JKamue/Rocketry/README.md

# Rocket projects

This serves as a common repository where I will document all my rocket builds and share as well as analyze the data generated from launching them.

<p align="center">
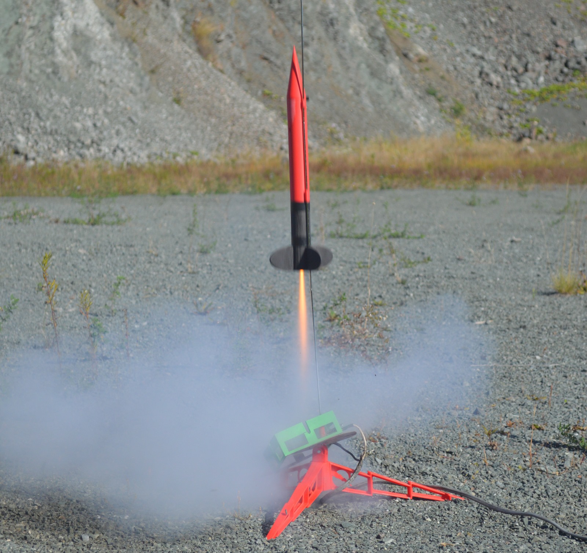
[picture p1: Pathfinder/DataAnalysis/title-picture.jpeg]
  
</p>

## Rockets

### Pathfinder

#### Goals
The goal of pathfinder was to test the viability of 3D printed rocket parts and cheap Sensors / Microcontrollers for use in a DIY rocket.

#### Launches

| Date | Outcome | Comment | Docs |
|--|--|--|--|
| 2024-09-29 17:39 | Partial failure | Destruction on impact when parachutes failed but full launch data was recorded and recovered | [Report](https://github.com/JKamue/Rocketry/releases/download/pathfinder/pathfinder.pdf) |
