JKamue/Rocketry/Pathfinder/DataAnalysis/analysis.pdf

# Exploring Low-Cost DIY Rockets with Flight Recording using 3D Printing and Low-Cost Sensors

### Design, Launch, Data Analysis, and Lessons Learned

### Jannes Kaspar-Müller

2024-11-03


## Contents

1 Goals | 4
2 Design | 5
3 Launch | 8
4 Conclusion | 29
5 Appendix | 30
References | 45

## List of Figures

1 | Rocket components and assembly | | 6
2 | Simulated rocket | | 7
3 | Altitude as measured by the barometric pressure sensor | | 8
4 | Vertical Speed as measured by the barometric pressure sensor | | 9
5 | Vertical Acceleration as measured by the barometric pressure sensor | 10
6 | Raw Acceleration as measured by the Accelerometer | 11
7 | Total Acceleration as measured by the Accelerometer | 12
8 | Rocket roll rotations during flight | 13
9 | Measured roll compared to maximum range | 14
10 | Amount of rotations around roll axis | 15
11 | GPS horizontal dilution of precision | 16
12 | Total speed measured by GPS | 17
13 | Altitude measured by GPS | 18
14 | 2D position of rocket based on GPS | 19
15 | Horizontal distance of rocket based on GPS | 20
16 | Horizontal speed of rocket based on GPS | 21
17 | Comparison of GPS and barometer altitude measurements | 22
18 | 3D position of rocket based on GPS and Barometer data | 22
19 | Total distance covered by rocket based on GPS and Barometer | 23
20 | Total speed of rocket based on GPS and Barometer | 24
21 | Total speed of rocket compared to vertical speed | 24
22 | Correlation between speed and roll | 25
23 | Rocket rotation during flight | 26
24 | Simulated altitude compared with measured altitude | 27
25 | Simulated vertical acceleration compared with measured acceleration | 28

## 1 Goals

1. The rocket should be easy and cheap to build. It should be possible to build multiple rockets of the same type and losing some of them should not hurt financially.
2. The rocket should be able to handle a variety of different motor sizes. Ideally a launch campaign would start at small altitudes and work its way up.
3. During the flight the rocket should be capable of recording as much flight data as possible and store it to be analyzed later.

## 2 Design

The design section is divided into three parts. The first covers the rocket’s overall design, detailing its structure and components. The second explains the simulations conducted to evaluate the rocket’s expected performance and stability. The final part outlines the features of the flight recorder and the key decisions made during its development.

### 2.1 Rocket Structure

The rocket follows a traditional hobbyist design, featuring a single motor located at the base with no active guidance system (Center, 2024). To ensure stability during flight, fins are positioned at the bottom. Additionally, since the rocket is intended for recovery, the nosecone must be detachable, triggered by the ejection charge from the motor. This requires the ejection blast to travel the full length of the rocket to the nosecone without damaging the on-board electronics responsible for recording flight data. Based on these goals, the following decisions were made regarding the design and manufacturing of the rocket:

### 2.1.1 The Case for 3D Printing

Due to the goals of affordability and easy of manufacturing the decision to use 3D printing to manufacture as many pieces of the rockets as possible was made. 3D printing allows anybody with access to the 3D model of the rocket to produce it nearly identical. The widespread adoption of 3D printing for hobby projects made printers as well as filament widely available, cheap to obtain and easy use. Therefore the rocket can not only be replicated with low complexity for the builder but also at a minimal cost or effort involved (Pearce & Qian, 2022). Additionally the process of 3D printing allows to easily build geometries that would usually be hard or expensive to machine or produce at small production volumes and scales (Berman, 2012, 2020). Specifically FDM 3D printing was used to build the complete Rocket structure.

Different 3D printing filaments offer different strength or density properties that might be more beneficial to use on different parts of the rocket (Bambu Lab, 2024). The most used hobbyist Filament, PLA, is an all rounder, offering good toughness, strength, stiffness, layer adhesion and ease of printing for a low price per kilogram. For this reason, PLA was chosen as the default material for most parts of the rocket that aren’t subjected to high forces or extreme temperatures.

The option of printing certain components in more expensive, ultra-lightweight filaments like ASA Aero (ASA infused with a temperature-activated foaming agent) was considered. However, this approach was ultimately set aside due to the reduced strength and increased printing complexity, which limits the ability to create intricate designs to some extent.

### 2.1.2 Selected Materials

There are 2 parts on the rocket that required further consideration before selecting the filament:

1. The fins of a rocket are often quite thin and stick out of the rocket body often making contact first when impacting during soft landings or transportation. Therefore requiring a higher impact resistance.
2. The parts coming into contact with the rocket motor will heat up more and should be made out of a material capable of handling higher temperatures than PLA.

Therefore these 2 parts were printed together in PA6-CF which features both a high impact and temperature resistance. The other parts of the rocket were all printed in cheap, easy to use PLA.


Figure 1: Rocket components and assembly

### 2.1.3 Parts

The rocket consists of 6 components.
The fins and motor assembly is split in two halves and screws into the white flight computer assembly. This allows mounting motors of different sizes by using various sized adapter before closing the motor assembly and screwing it in.
The red tube is just a cover with holders for the launch rods as well as openings for LEDs and sensors. The detachable nosecone is placed on top of the tube. A small thin disk is placed on top of the flight recorder to create a small parachute compartment. On top of the parachute compartment a nose cone is placed loosely. The flight computer assembly is built around a hollow tube that starts at the motor assembly. This directs the blast upwards to the parachute compartment. The blast will push the parachute against the nose cone, separating it from the rocket and opening up the parachute.

### 2.2 Performance & Stability Simulations

The whole rocket with all parts and weights was replicated in OpenRocket to predict the stability and flight characteristics. Later on the actual data will be compared with the simulated data.

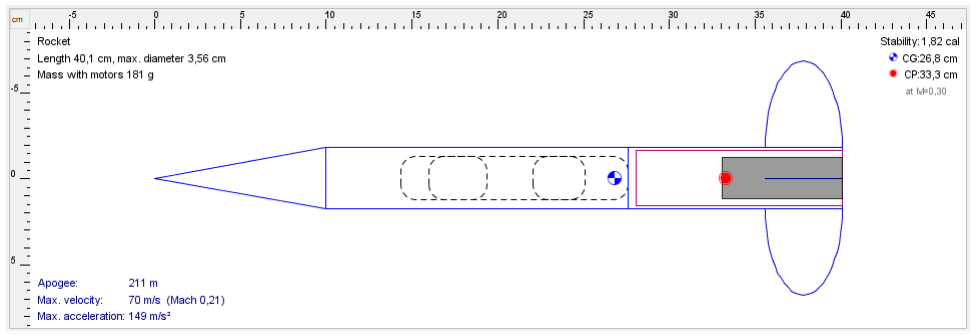
[picture p4: figure]

Figure 2: Simulated rocket

### 2.3 Flight Recording System

The goal of the flight recording system was to cheaply record as much data as possible. The heart of the system was a Lolin32. The WiFi capability allowed connecting to the flight recording system on the launch pad to ensure that all sensors were working. Additionally it supports charging and using a small 3.7v LiPo battery which was used to power the rocket during flight.
To store the recorded data a cheap SPI micro SD module was used.
3 types of sensors were added to the flight recording system. All of them are widely available and cheap making them ideal to build multiple flight recorders in the future without being afraid of losing some.
1. For measuring barometric pressure the BMP388 was chosen. This sensor should be able to provide the most accurate altitude data.
2. To measure the rockets acceleration and orientation the MPU6050 was chosen as an IMU.
3. In order to get the precise location of the rocket above the ground the BE-220 was used as a GPS. The GPS was also re-programmed to allow for a higher data rate.

## 3 Launch

In this chapter I will first analyse the launch based on the data the various sensors recorded. Following that I will compare the actual measurements with the result of the simulation. This chapter concludes with a failure analysis that summarizes all encountered issues and investigates their root causes, aiming to prevent similar and related failures in the future.

The launch was conducted with a D12-5 motor.

### 3.1 Data Analysis

The data analysis will first take a look at each sensors individual measurement. At the end the data of multiple sensors will be combined to get a more comprehensive understanding of the flight and to compare performance as well as accuracy of sensors.

### 3.1.1 Pressure Sensor

The primary function of the barometric pressure sensor is to measure the rocket’s altitude throughout its flight. With an accuracy of approximately ±8 Pa, it can determine altitude to within ±0.5 m (Gravity, 2020). Since each point in the following figure represents the difference between the initial ground measurement and the reading at that specific moment, the cumulative accuracy adjusts to about ±1m — still providing a very reliable measurement. Additionally locally weighted scatterplot smoothing (LOWESS) has been used to plot an additional curve that is less susceptible to the minor variations in the sensors measurements.

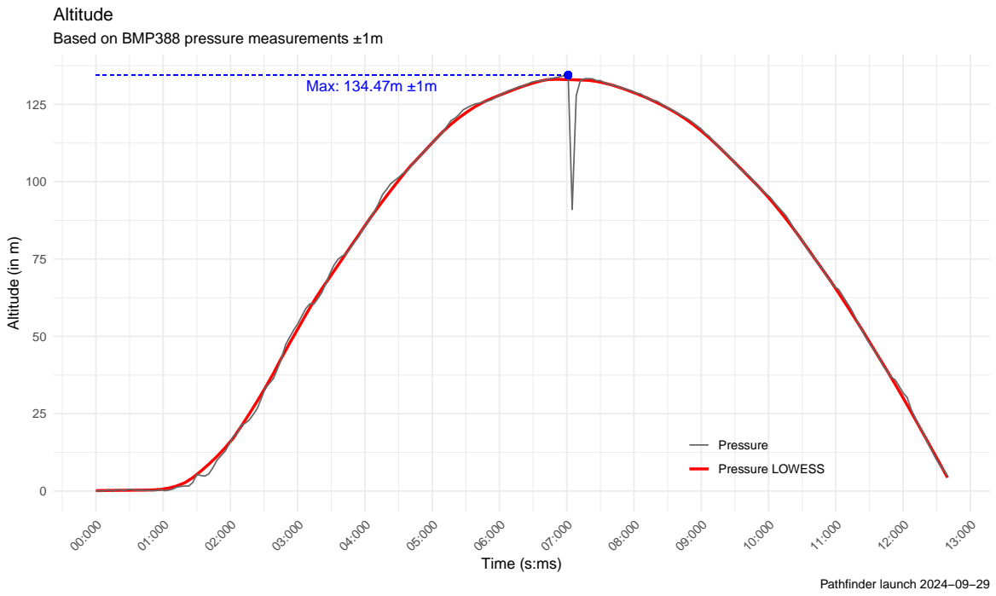
[picture p5: figure]
Max: 134.47m ±1m; Time (s:ms); Altitude (in m); Pressure; Pressure LOWESS; Altitude; Pathfinder launch 2024−09−29

Based on BMP388 pressure measurements ±1m

Figure 3: Altitude as measured by the barometric pressure sensor

The data shows a steep ascent between 1:00 and 2:00 followed by a slow increase until the peak of 134.47m is reached at 7:00. At this point all upwards velocity is lost due to gravity and friction. Gravity now continues to accelerate the rocket towards the ground again. Since the rocket moves faster and faster towards the ground it becomes apparent that the parachute system failed. The ejection charge was supposed to release the parachute at roughly 8:00 but the nose did not manage to seperate causing the rocket to impact the ground without slowing down.

The sudden drop shortly after the peak is reached (or perhaps covering the timeframe where the peak was really reached) is quite interesting to see. It’s difficult to determine whether this dip is due to measurement error occurring coincidentally at this time, or if the rocket encountered a unique pressure phenomenon at its peak Additional flights might bring more insight if this is merely a correlation or if this is actually caused be the rocket reaching its peak. Perhaps future flights might also profit from redundant sensors.

Using the altitude data, the gradient of altitude can be calculated to determine the rocket’s vertical speed. While the barometric pressure recorded by the sensor might look smooth at a first glance it becomes apparent that the minimal variations in the sensors measurements result in huge spikes when calculating the gradient. Calculating the gradient of the altitiude LOWESS yields a lot better and cleaner results that should still be very accurate since it only reduces the variation and doesnt alter the curves trajectory. This graph shows that the maximum vertical speed was around 40 m/s.

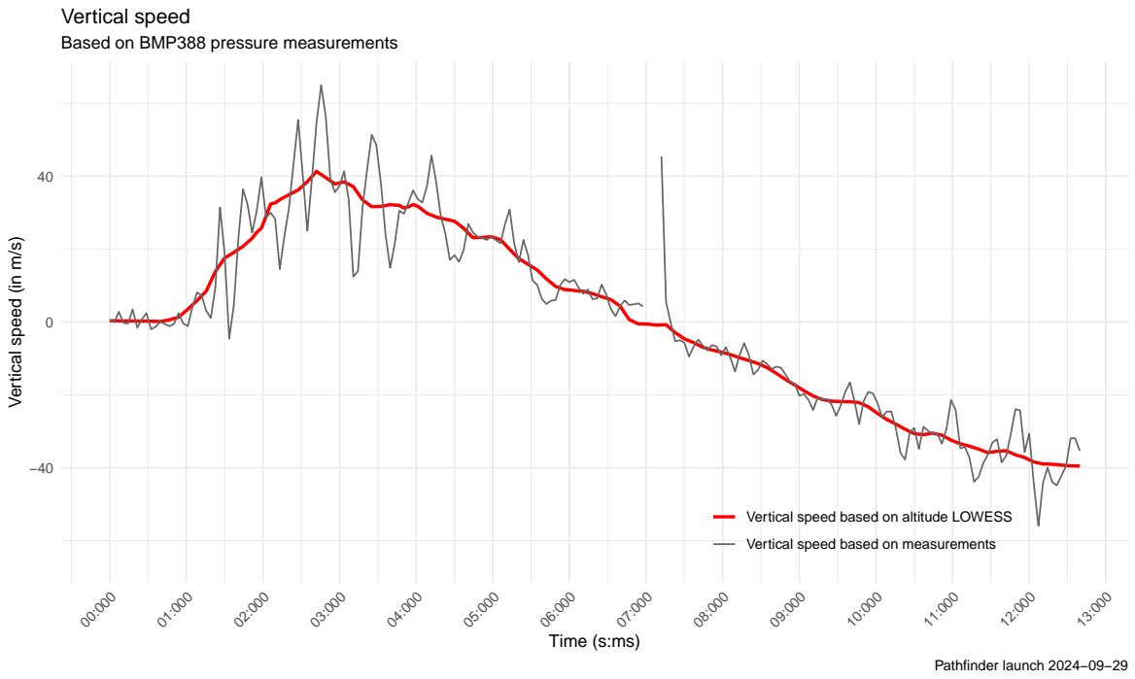
[picture p6: figure]
Time (s:ms); Vertical speed (in m/s); Vertical speed based on altitude LOWESS; Vertical speed based on measurements; Based on BMP388 pressure measurements; Vertical speed; Pathfinder launch 2024−09−29

Figure 4: Vertical Speed as measured by the barometric pressure sensor

Trying to calculate a gradient from either of the calculated vertical speeds yielded no usable results. In this case even the variations of the LOWESS are to significant to produce usable data. Perhaps calculating another LOWESS based on the Vertical speed LOWESS might produce nicer looking results but it is questionable how accurate those would still be.

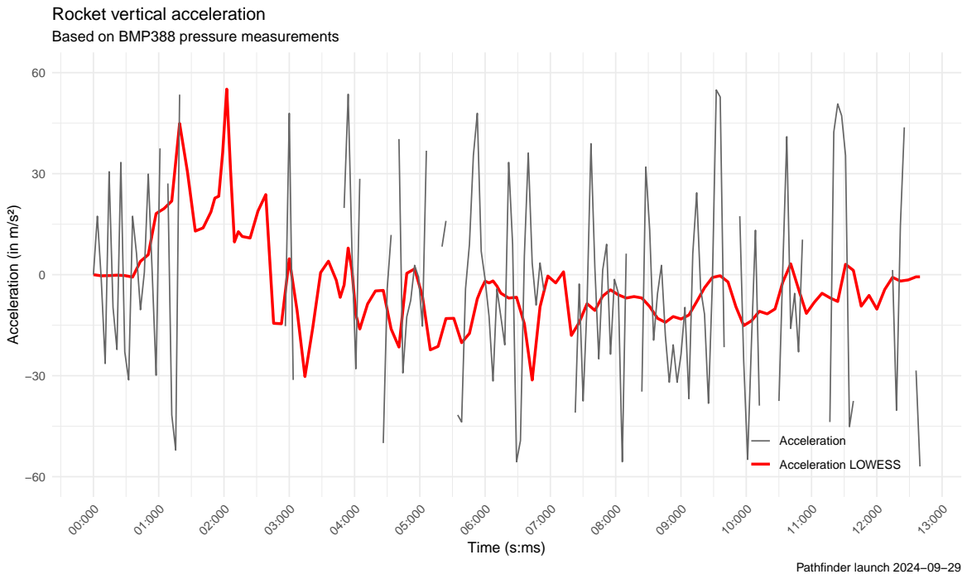
[picture p7: figure]
Time (s:ms); Acceleration (in m/s²); Acceleration; Acceleration LOWESS; Based on BMP388 pressure measurements; Rocket vertical acceleration; Pathfinder launch 2024−09−29

Figure 5: Vertical Acceleration as measured by the barometric pressure sensor

The barometric pressure sensor is the perfect sensor for determining the altitude during the flight accurately. The high velocity of the rocket does not seem to have decreased the quality of measurements except perhaps the sudden decrease and increase shortly after or during the peak of the rocket. Variations in the individual measurements make it hard to calculate a gradient but using local regression it is possible to still determine the speed of the rocket during the launch. The variations seem to be to high to calculate the acceleration of the rocket though which is a bummer since it would have been interesting to compare the vertical acceleration measured by the pressure sensor and the accelerometer.

### 3.1.2 Accelerometer

The accelerometer recorded the acceleration of the rocket in 3 axis during the launch. The most interesting axis is the vertical axis labeled with Y in the graphic below. As expected the vertical acceleration matches the thrust curve of a D12-5 engine in shape and duration (Estes, 2023) confirming the validity of measurements to some degree.

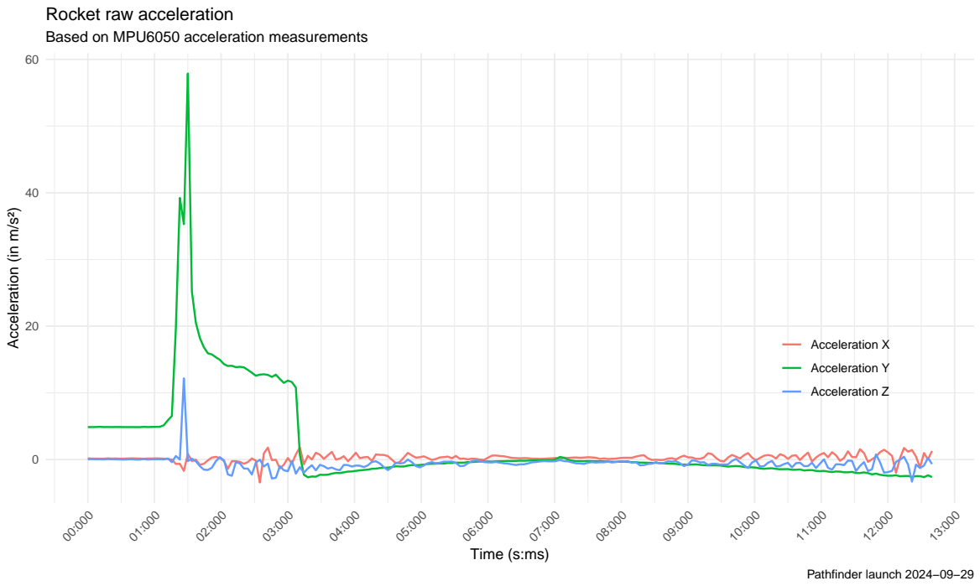
[picture p8: figure]
Time (s:ms); Acceleration (in m/s²); Acceleration X; Acceleration Y; Acceleration Z; Based on MPU6050 acceleration measurements; Rocket raw acceleration; Pathfinder launch 2024−09−29

Figure 6: Raw Acceleration as measured by the Accelerometer

While the general shape of the thrust might look okay and follow expectations a closer inspection shows that the accelerometer data is actually flawed. During the period on the ground before lift-off there should have been a force of roughly 9.81 m/s² representing gravity. Instead the total acceleration on all axis before liftoff was only 4.87-4.91m/s². This seems to be pretty exactly half of the expected acceleration hinting at a scaling issue in either the library or the accelerometers scale factor that is calibrated at the factory. Simply multiplying measured values by two yielded unsatisfactory results and it is very likely that poor understanding and integration of this sensor ahead of flight made the data unusable.

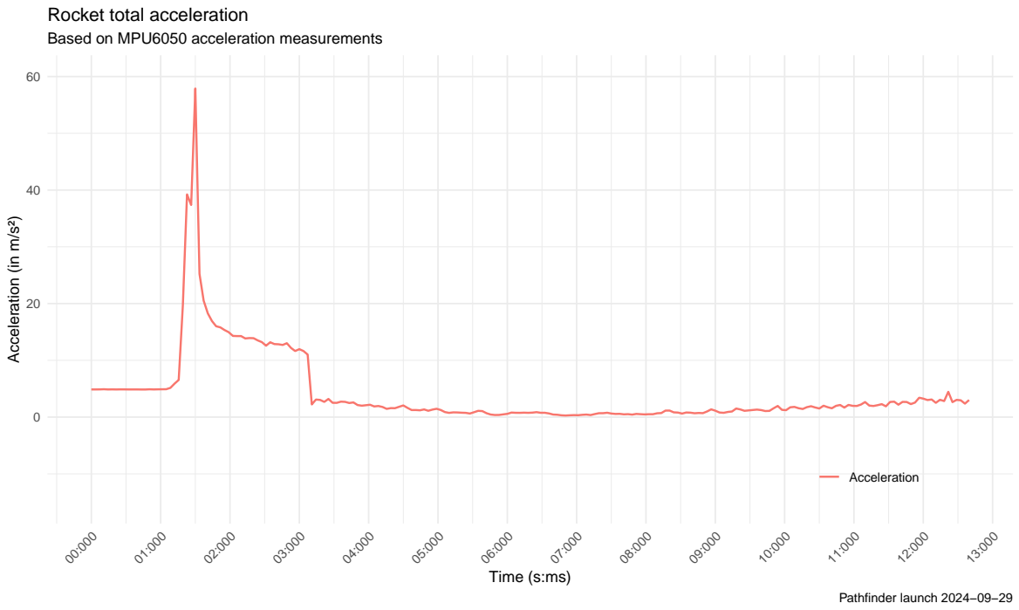
[picture p9: figure]
Time (s:ms); Acceleration (in m/s²); Acceleration; Based on MPU6050 acceleration measurements; Rocket total acceleration; Pathfinder launch 2024−09−29

Figure 7: Total Acceleration as measured by the Accelerometer

Further flights must take a closer look at the accelerometer before launching, particularly ensuring that the expected acceleration of gravity is present before launch for the collected data to be trustworthy. Also settings like the accelerometer range and filter bandwidth as well as other settings must be better understood before taking flight. It might also make sense to compare multiple different libraries or reading the sensor directly to get all the raw data that can be processed after and not during the flight.

### 3.1.3 Gyroscope

The angular speed measured by the gyroscope during the flight can be seen below. It is immediatelly obvious that the rocket experienced the highest angular speed around its roll axis during the flight.

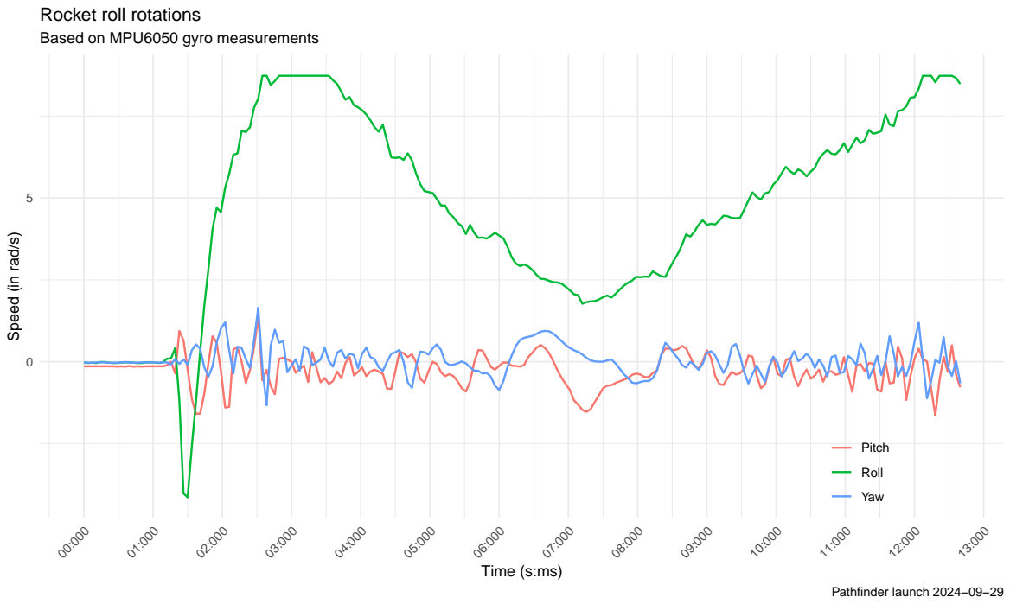
[picture p10: figure]
Time (s:ms); Speed (in rad/s); Pitch; Roll; Yaw; Based on MPU6050 gyro measurements; Rocket roll rotations; Pathfinder launch 2024−09−29

Figure 8: Rocket roll rotations during flight

As seen here the roll speed of the rocket was even greater than the limit of 500 deg/s. This limit was arbitrarily chosen before the flight and options for 1000 deg/s as well as 2000 deg/s were also available. The chart highlights that this limit was crossed in two intervals during the flight leading to the loss of data that could have been prevented with a better understanding of data ranges before the flight. It also is visible, that the highest roll speed was achieved during ascent an descent of the rocket.

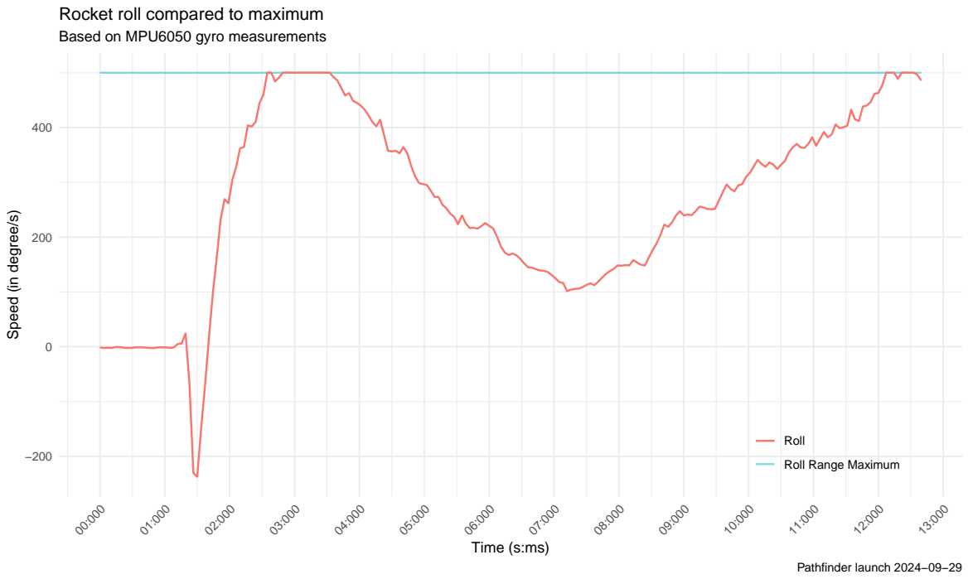
[picture p11: figure]
Time (s:ms); Speed (in degree/s); Roll; Roll Range Maximum; Based on MPU6050 gyro measurements; Rocket roll compared to maximum; Pathfinder launch 2024−09−29

Figure 9: Measured roll compared to maximum range

Overall the roll axis speed was quite high. Calculating the total amount of rotations by integrating the speed shows that the rocket did at least 9.39 rotations in a timeframe of 11.1 seconds averaging 0.85 rotations per second. Since roll data was lost the actual amount of rotations is assumed to be even higher. This is significant because future rockets might have a camera attached to them. A high roll rate will make the recorded footage during ascent and decent unusable.

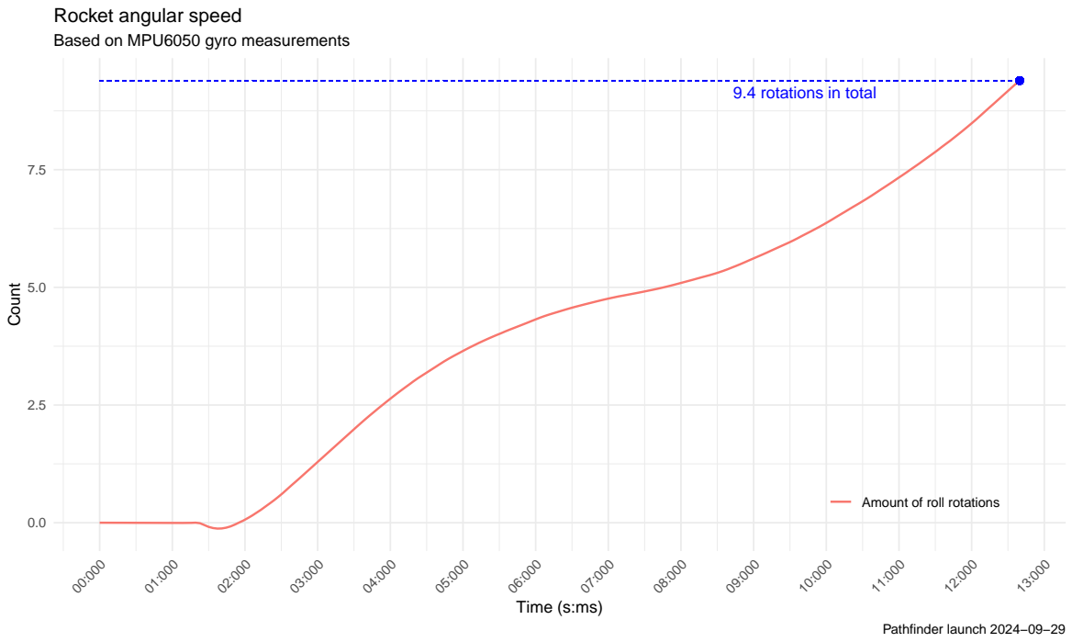
[picture p12: figure]
9.4 rotations in total; Time (s:ms); Count; Amount of roll rotations; Based on MPU6050 gyro measurements; Rocket angular speed; Pathfinder launch 2024−09−29

Figure 10: Amount of rotations around roll axis

Even though this rocket did not use any active steering method the gyro measurements still provided valuable data. Understanding the stability of the rocket during the flight is crucial for further rocket builds. A later graphic will also show the rocket orientation during the flight. Once again the sensor and the expected values were poorly understood before the launch. This resulted in the choice for an insufficient measurement range leading to the loss of some roll data.

### 3.1.4 GPS

An error in the flight recorder software caused it not to record the amount of visible satellites during the launch. This would have been interesting data to have to compare signal accuracy with different numbers of satellites. Additionally only the horizontal dilution of precision (HDOP) was tracked since the used library did not include the vertical dilution of precision (VDOP) by default. In hindsight this data would still have been relevant and should be recorded for future launches.

The chart below shows the HDOP during the flight on a logarithmic scale. The 0.54s period with a very high HDOP is noticeable and will also be highlighted in following graphics that might require horizontal precision.

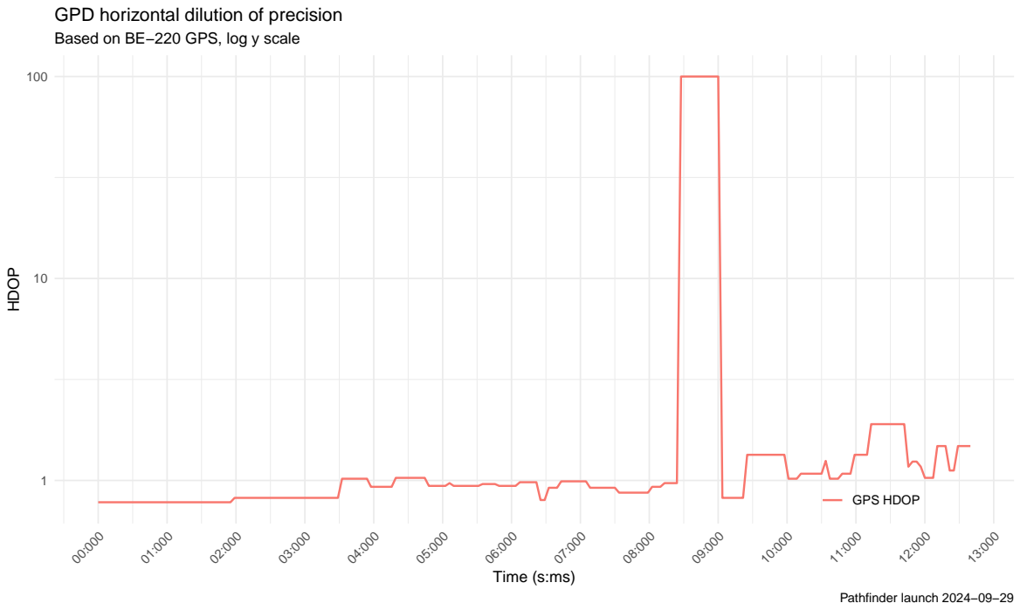
[picture p13: figure]
Time (s:ms); HDOP; GPS HDOP; Based on BE−220 GPS, log y scale; GPD horizontal dilution of precision; Pathfinder launch 2024−09−29

Figure 11: GPS horizontal dilution of precision

The total speed of the rocket as tracked by the gps is very inaccurate with big jumps and does not match the actual flight path or the data obtained by the barometric pressure sensor a lot. The brief period with high HDOP seems to have no influence on the tracked speed.

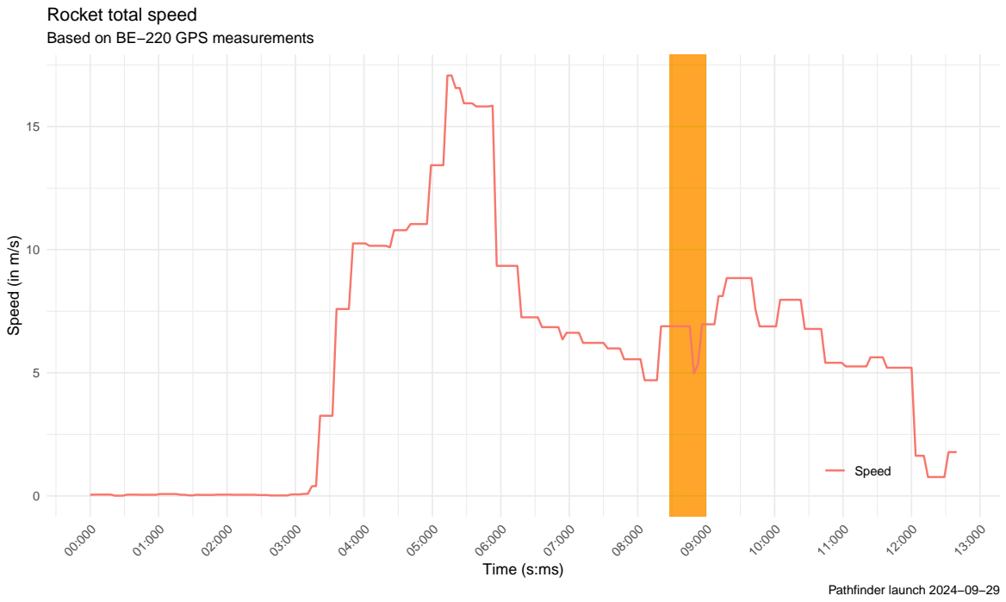
[picture p14: figure]
Time (s:ms); Speed (in m/s); Speed; Based on BE−220 GPS measurements; Rocket total speed; Pathfinder launch 2024−09−29

Figure 12: Total speed measured by GPS

The altitude data recorded by the gps seems to have a very strong delay. It first measured a noticeable ascent of the rocket 5 seconds after the actual launch.

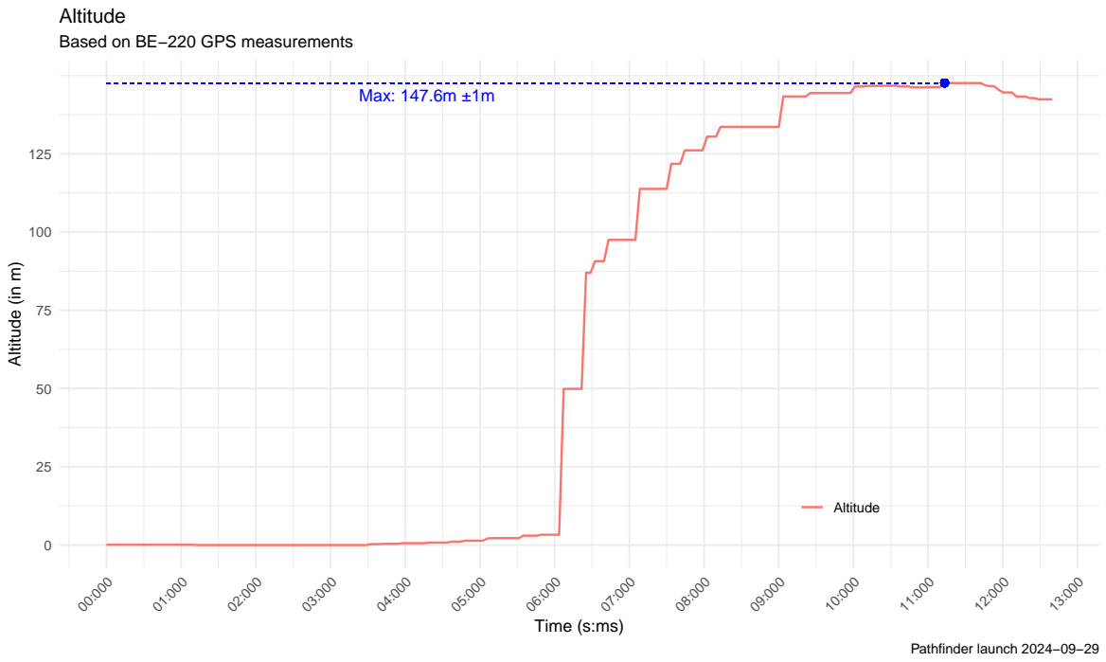
[picture p15: figure]
Max: 147.6m ±1m; Time (s:ms); Altitude (in m); Altitude; Based on BE−220 GPS measurements; Pathfinder launch 2024−09−29

Figure 13: Altitude measured by GPS

The most interesting data recorded by the GPS is most likely the 2D position of the rocket. No other sensor on the rocket was capable of measuring the data. The following chart shows the path of the rocket as seen from above. This also shows that there was quite a big jump in the recorded gps data. It is unlikely that the rocket actually flew exactly this path.

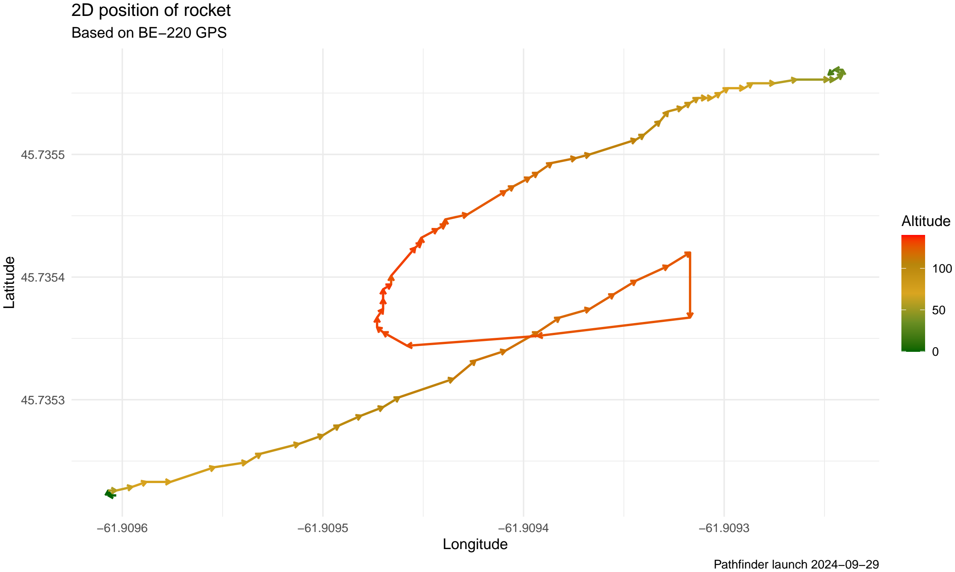
[picture p16: figure]
Longitude; Latitude; Altitude; Based on BE−220 GPS; 2D position of rocket; Pathfinder launch 2024−09−29

Figure 14: 2D position of rocket based on GPS

Calculating the horizontal distance covered by the rocket based on the individual gps 2D positions yields the grey curve. Using the lowess it is possible to exclude the sudden jump caused by the gps mid-flight. Using the previous chart and this one it becomes apparent that the rocket covered a lot more horizontal ground during ascent than descent.

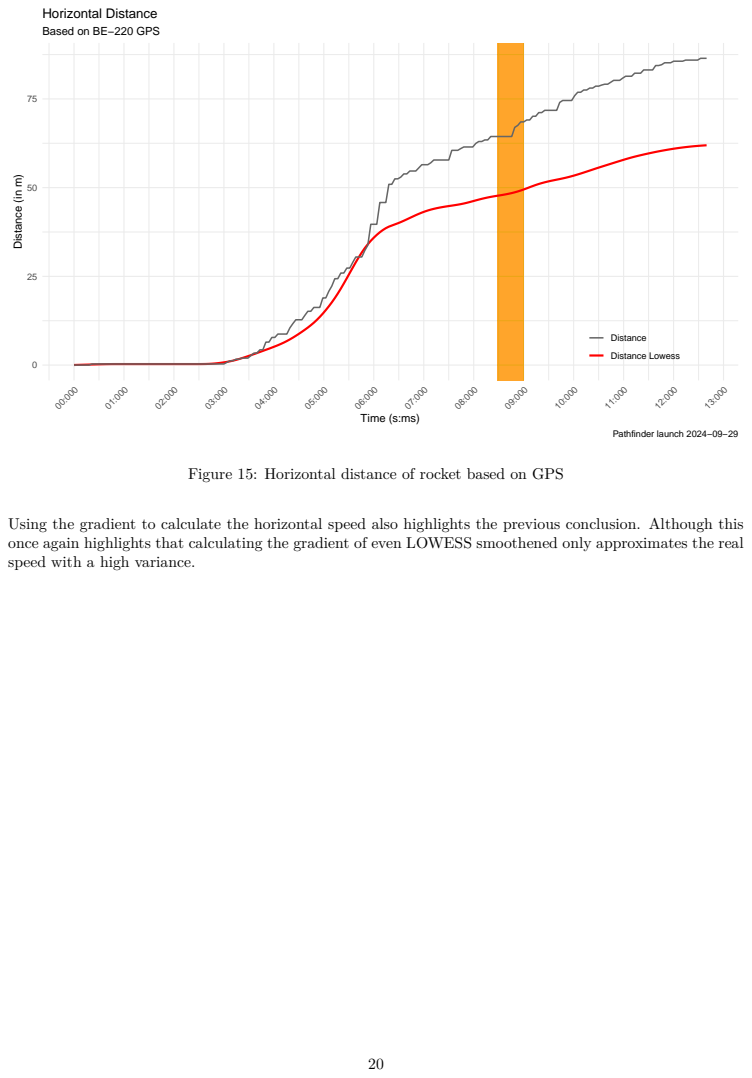
[picture p17: page 20]
Time (s:ms); Distance (in m); Distance; Distance Lowess; Pathfinder launch 2024−09−29

Horizontal Distance
Based on BE−220 GPS

Figure 15: Horizontal distance of rocket based on GPS

Using the gradient to calculate the horizontal speed also highlights the previous conclusion. Although this
once again highlights that calculating the gradient of even LOWESS smoothened only approximates the real
speed with a high variance.

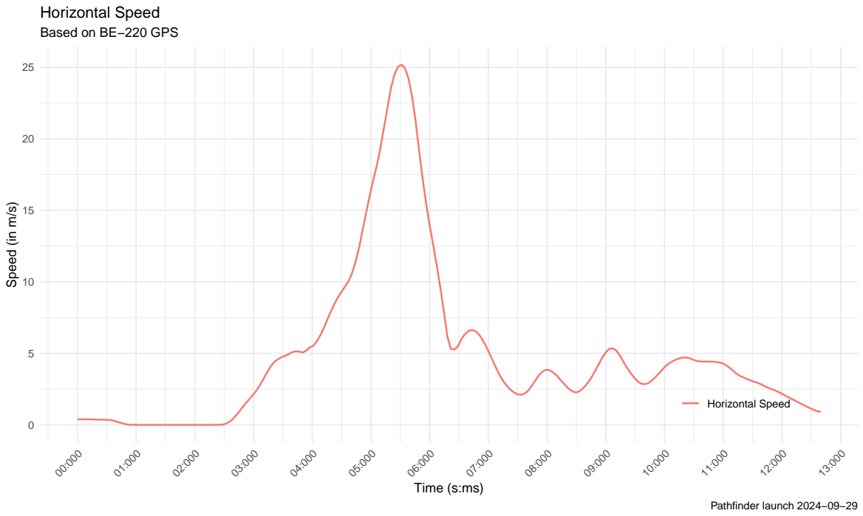
[picture p18: figure]
Time (s:ms); Speed (in m/s); Horizontal Speed; Based on BE−220 GPS; Pathfinder launch 2024−09−29

Figure 16: Horizontal speed of rocket based on GPS

Overall the gps measured some unique data like the absolute position of the rocket and the 2D track of the rocket. Altitude and speed measurements seem to be inaccurate though and the gps seems to have quite a high delay at times. The 2D position of the rocket often was redundant with multiple measurements having the same coordinates. Additionally there was a sudden jump in gps positions decreasing the quality of the data a lot. For future launches it should be checked if there are setting to decrease jumps or the delay.

### 3.1.5 Combining measurements

The previous chapters only looked at the data measured by individual sensors. The goal of this chapter is to explore if combining and enhancing data collected by different sensors will result in new insights. This also makes it possible to compare the quality of data recorded by different sensors.

Gps and barometric pressure sensor are both capable of measuring the rockets altitude during the flight. The following graphic shows the altitude measured by the GPS in green and the barometric altitude in blue. It is obvious that the gps data contains a lot more jumps and it seems to be delayed by quite a bit. The red line syncs barometric pressure and gps at their respective peaks. While peak measured by the gps is only off by 13.13 ±1m the data overall doesnt describe the ascent of the rocket very well. Moving forward the altitude measured by the barometric pressure sensor will be used when determining the altitude of the rocket.

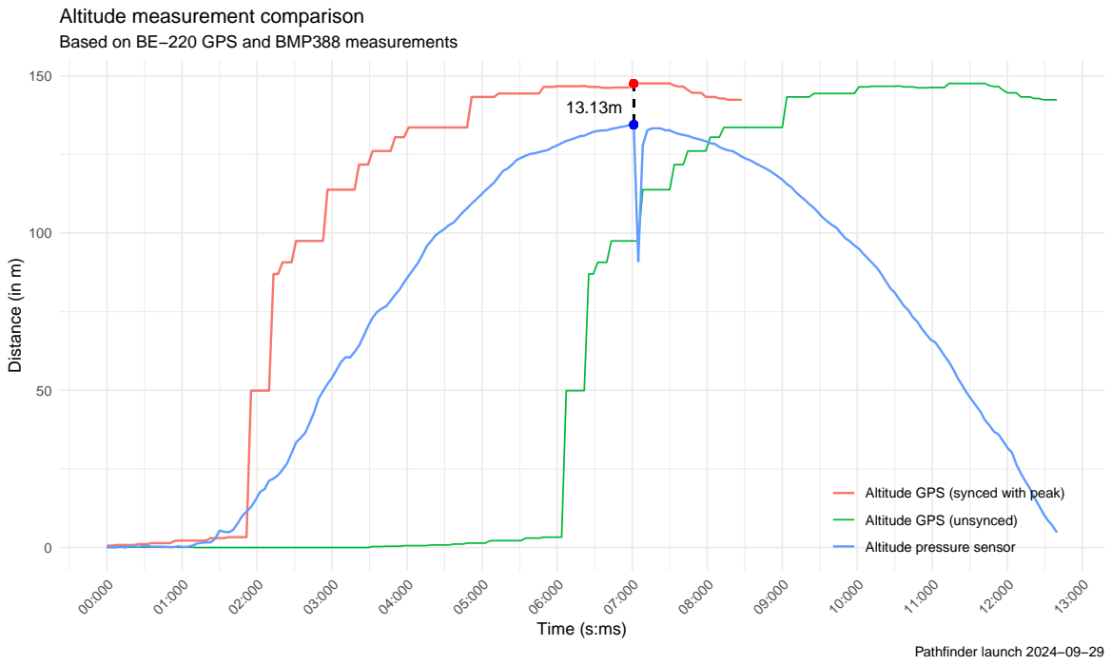
[picture p19: figure]
Time (s:ms); Distance (in m); Altitude GPS (synced with peak); Altitude GPS (unsynced); Altitude pressure sensor; Altitude measurement comparison; Pathfinder launch 2024−09−29

Based on BE−220 GPS and BMP388 measurements

Figure 17: Comparison of GPS and barometer altitude measurements

Using the altitude measured by the pressure sensor and the 2D position measured by the gps makes it possible to approximate the flight path of the rocket in 3D.

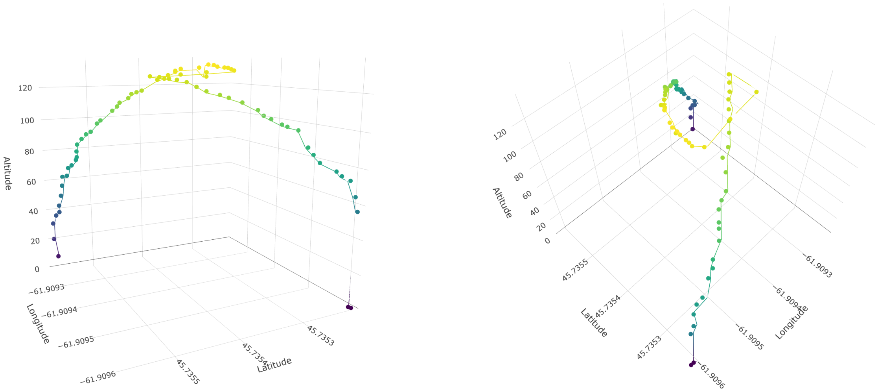
[picture p20: figure]

Figure 18: 3D position of rocket based on GPS and Barometer data

Based on this 3D flight path it is possible to calculate the total distance covered by the rocket.

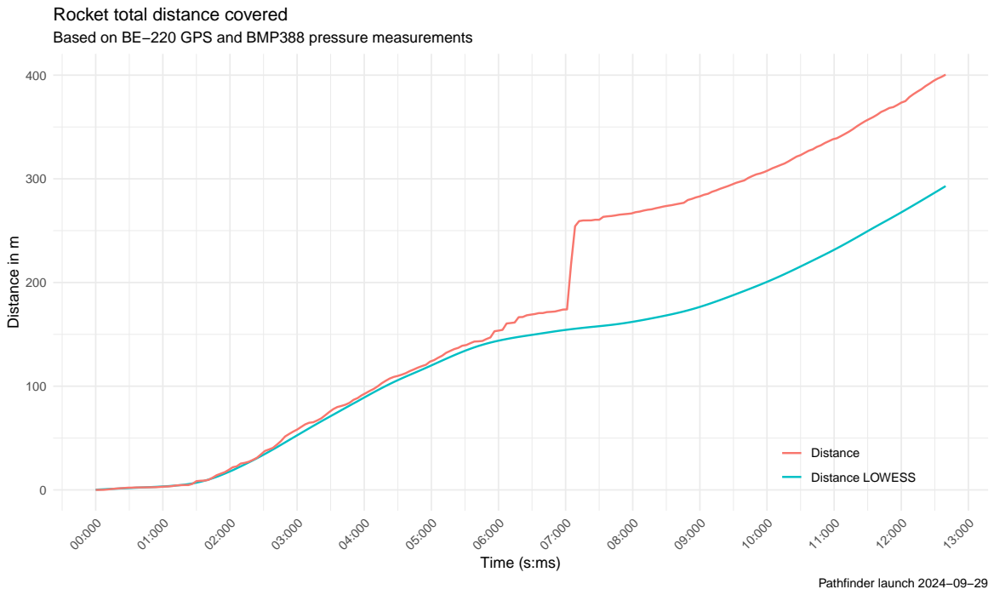
[picture p21: figure]
Time (s:ms); Distance in m; Distance; Distance LOWESS; Rocket total distance covered; Pathfinder launch 2024−09−29

Based on BE−220 GPS and BMP388 pressure measurements

Figure 19: Total distance covered by rocket based on GPS and Barometer

And by calculating the gradient of that the total speed of the rocket can be calculated. Previous speed measurements were mostly horizontal or vertical speed, making this chart as the rockets true speed quite interesting. This shows how combining gps and barometric data can result in a new understanding of the rocket during flight.

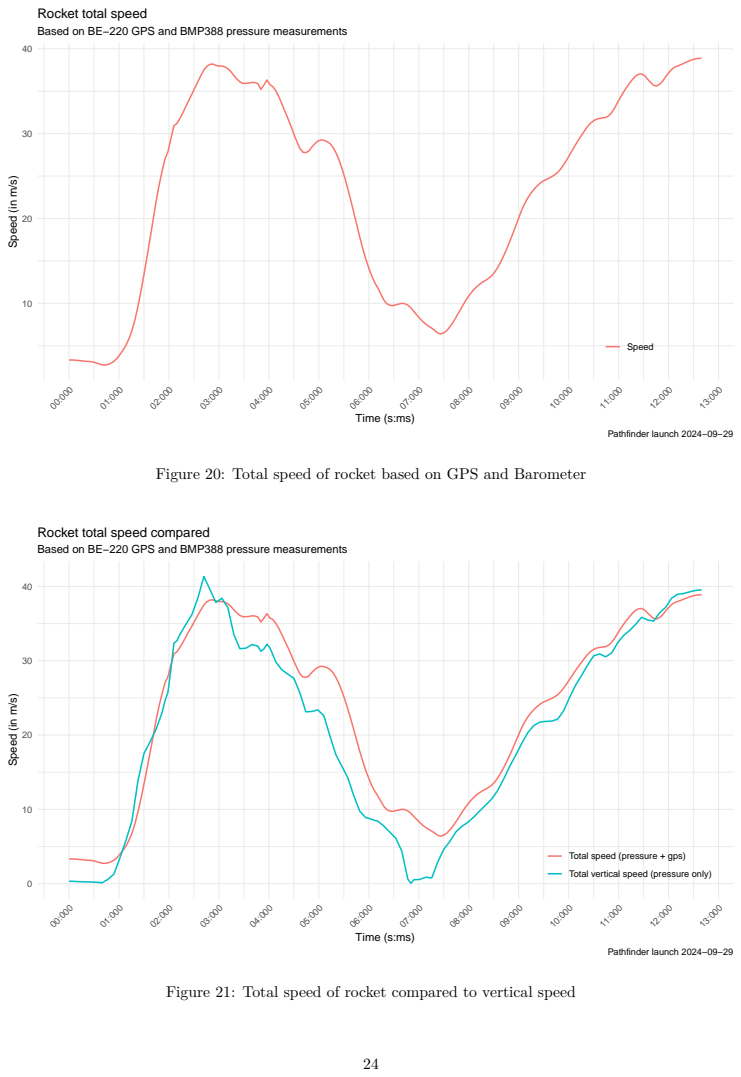
[picture p22: page 24]
Time (s:ms); Speed (in m/s); Speed; Pathfinder launch 2024−09−29

Rocket total speed
Based on BE−220 GPS and BMP388 pressure measurements

Figure 20: Total speed of rocket based on GPS and Barometer

Rocket total speed compared

Total speed (pressure + gps)
Total vertical speed (pressure only)

Figure 21: Total speed of rocket compared to vertical speed

Using the data of multiple sensors can also explain the nature of the high roll rate mentioned earlier. The total speed calculated above and the roll rate have a correlation of 0.927. Therefore they are strongly correlated. The chart below uses two different scales with a scale factor to highlight this relationship. This data points to an asymmetric geometry of the rocket causing uneven drag at high speeds. Most likely this is due to the fins not aligning perfectly and being at a slight angle.

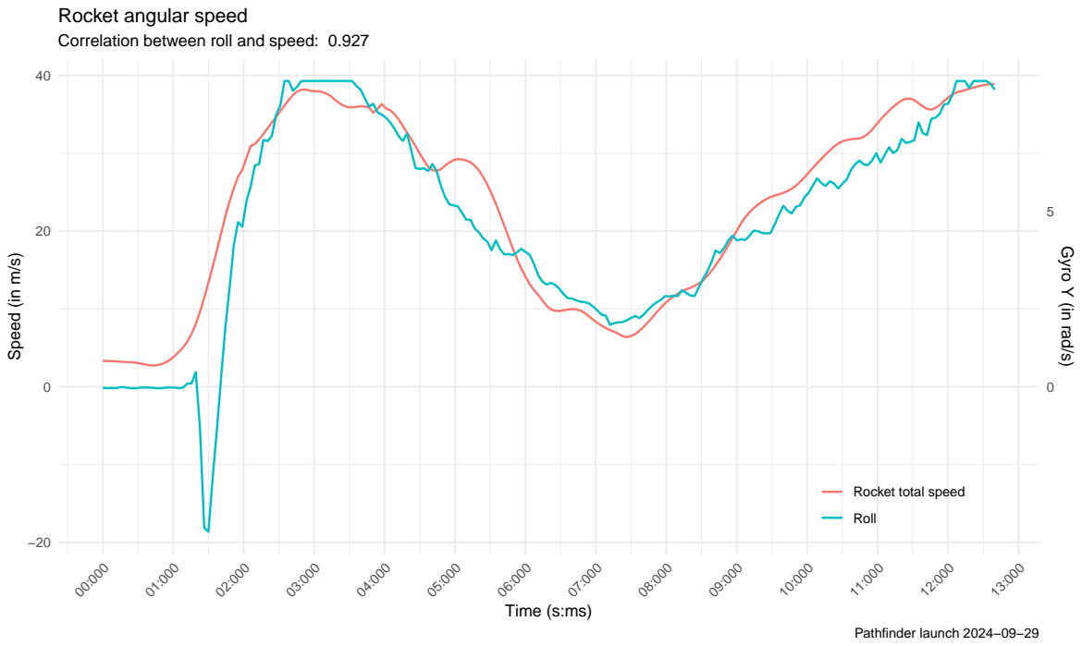
[picture p23: figure]
Time (s:ms); Speed (in m/s); Gyro Y (in rad/s); Rocket total speed; Roll; Rocket angular speed; Pathfinder launch 2024−09−29

Correlation between roll and speed: 0.927

Figure 22: Correlation between speed and roll

The rockets orientation during the flight can also be displayed by using the barometric pressure sensors altitude and the rockets orientation measured by the gyro sensor. It is important to note that the x-axis here does not track distance but time.

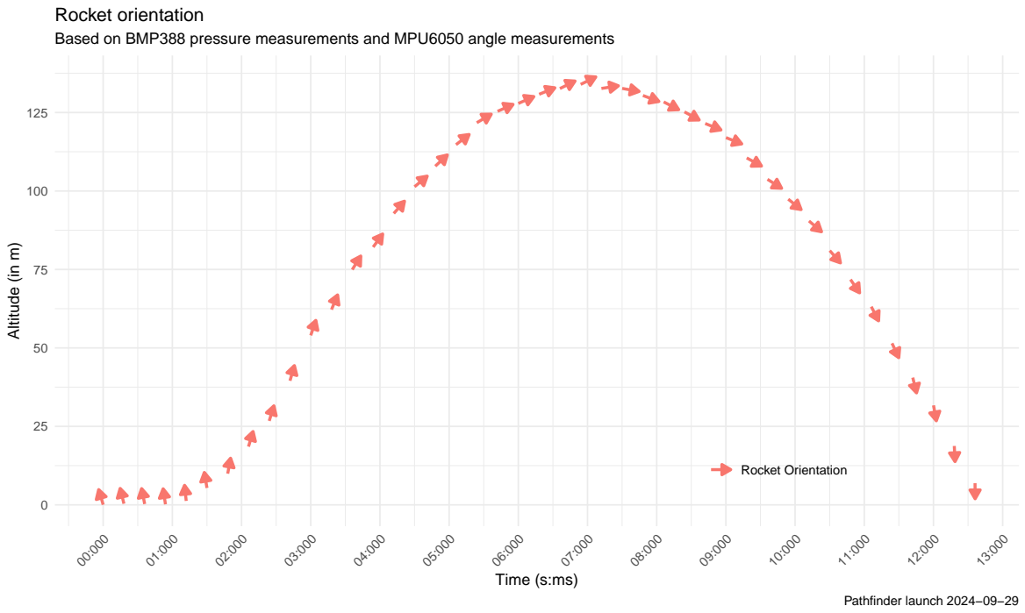
[picture p24: figure]
Time (s:ms); Altitude (in m); Rocket Orientation; Rocket orientation; Pathfinder launch 2024−09−29

Based on BMP388 pressure measurements and MPU6050 angle measurements

Figure 23: Rocket rotation during flight

### 3.2 Comparison with simulation

Weirdly enough the data recorded does not match the simulations at all. The achieved altitude was a lot lower than the simulated altitude.

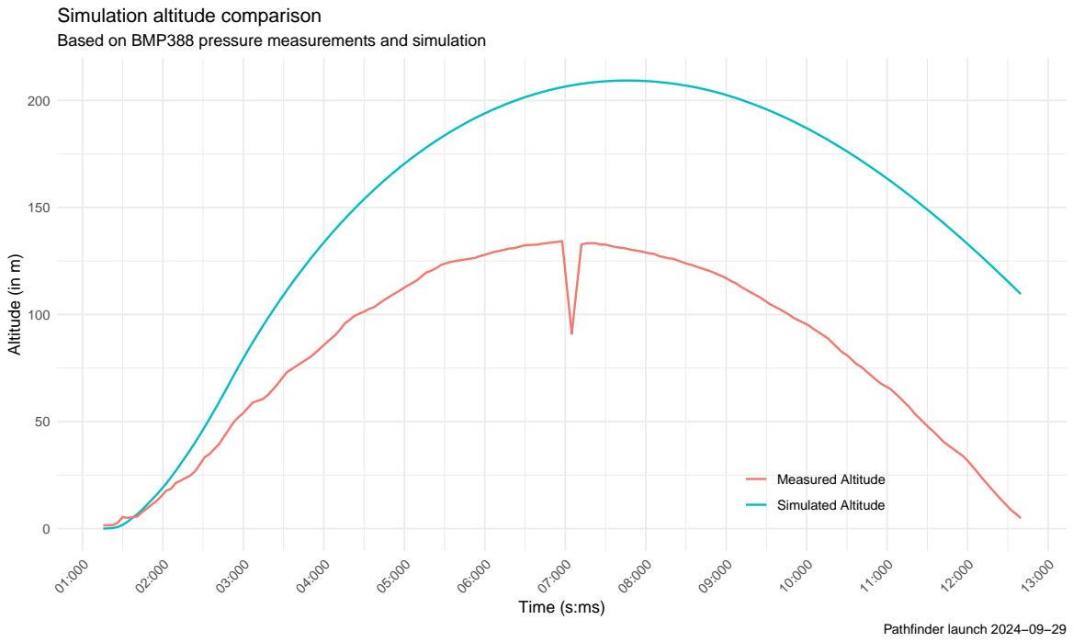
[picture p25: figure]
Time (s:ms); Altitude (in m); Measured Altitude; Simulated Altitude; Simulation altitude comparison; Pathfinder launch 2024−09−29

Based on BMP388 pressure measurements and simulation

Figure 24: Simulated altitude compared with measured altitude

Comparing the thrust of the simulation with the actual thrust shows that the simulated D12 engine behaved a lot differently than the real one. It burned longer and most likely with a lot less thrust resulting in the reduced altitude. Even increasing the weight or friction of the rocket will not result in such big differences in acceleration and the burn time should have been the same either way.

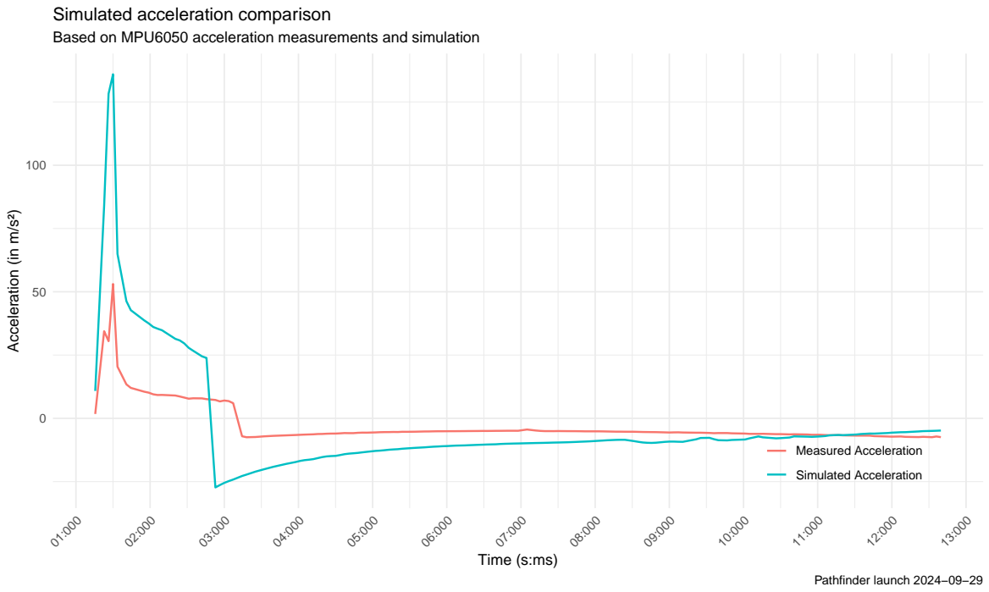
[picture p26: figure]
Time (s:ms); Acceleration (in m/s²); Measured Acceleration; Simulated Acceleration; Simulated acceleration comparison; Pathfinder launch 2024−09−29

Based on MPU6050 acceleration measurements and simulation

Figure 25: Simulated vertical acceleration compared with measured acceleration

For future launches the simulation software has to be better understood and the root cause of this large difference has to be identified. Otherwise judging the altitude and trajectory of the rocket prior to launch will not be possible.

### 3.3 Failure Analysis

The parachute compartment of the rocket was way to small to fit a properly sized parachute. During the design phase there was no parachute on hand resulting in very rough and very wrong estimations. This is why integrating a properly sized parachute was impossible. Even a smaller parachute barely fit, had to be folded incorrectly and was cramped into the available space. Ultimately cramping the parachute in was the reason it jammed and failed to deploy.

The parachute was once tested successfully on the ground using an A motor. In theory the system with a hollow inner tube directing the ejection charge to the nozzle works. Most likely the only thing needed to fix the parachute system is a longer rocket.

## 4 Conclusion

### 4.1 Critical Reflection

### 4.1.1 Mistakes

In hindsight multiple mistakes in the rockets design and launch are obvious.

4.1.1.1 Insufficient understanding of sensors In multiple occasions and for multiple different sensors there was not enough planning concerning the calibration and settings used.
This was especially noticeable with the IMU. The accelerometer was not studied in detail before the launch resulting in unusable data. For the gyroscope the expected data range was not correctly set resulting in some data loss concerning the rockets roll.
The gps had an error where it only wrote 0 for the amount of available satellites onto the SD card. Additionally the data included large jumps during the launch that may have been prevented with proper settings. Due to bad research valuable data like VDOP was not known before the launch and not recorded during the flight.

4.1.1.2 Bad planning The parachute compartment was way to small. The design and manufacturing techniques used would have easily allowed for a larger parachute area. But during the design the parachute was the only part that was not on hand and not measured out to test with the overall build. This eventually lead to the rocket crashing.
Additionally the simulation did not match the actual flight characteristics but this has to be looked into further.

### 4.1.2 Successes

Even though the rocket crashed recovering it was never a main goal. Recovering the data itself can already be considered a success and provided valuable insight into the flight. It was possible to prove that 3D printed rockets are not only cheap to produce but also make creating complex geometries easy. Additionally the viability of different sensors could be proven and the lessons learned from bad sensor readings will be applied on future flights.
Overall I do not deem this launch a failure since all the initial goals were achieved. Recovering the rocket intact would have been nice though.

### 4.2 Next steps

I would like to have these features on future rockets (ordered by decreasing importance):

1. Fixing all outlined sensor issues
2. A working parachute system
3. A built in camera filming the rockets POV during the flight
4. The ability for the rocket to launch itself allowing the flight recorder to know the precise time the engine was lit
5. Custom made PCBs instead of soldered together sensor modules
6. A recovery system where the rocket can transmit its location after landing

## 5 Appendix

### 5.1 Raw barometric pressure sensor data

Milliseconds | Temperature | Pressure | Altitude
1393931 | 36.77 | 101069.30 | 21.30
1393991 | 36.77 | 101068.85 | 21.34
1394051 | 36.77 | 101069.40 | 21.29
1394111 | 36.77 | 101064.82 | 21.67
1394171 | 36.77 | 101069.70 | 21.26
1394231 | 36.77 | 101066.84 | 21.62
1394291 | 36.77 | 101067.32 | 21.67
1394351 | 36.76 | 101067.70 | 21.43
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
Pearce, J., & Qian, J.-Y. (2022). Economic impact of diy home manufacturing of consumer products with low-cost 3d printing from free and open source designs. European Journal of Social Impact and Circular Economy, 3(2), 1–24.
