JKamue/Rocketry/(commit log)

2024-10-22 feat(pathfinder): create charts for paper
    [pathfinder-launch-1.csv]
2024-10-29 feat(pathfinder): add analysis comparing simulation and achieved results
    [pathfinder-simulated-launch.csv]
2024-10-30 feat(pathfinder): added thoughts on pressure sensor data
2024-10-30 feat(pathfinder): added thoughts on accelerometer data
2024-10-31 feat(pathfinder): added text for gyroscope data
2024-11-03 feat(pathfinder): finished sensor measurements chapter
